schaefm2/BOPIT/README.md

# BOPIT
This repository contains the tutorial pdf and code for a BOPit glove
